DomenicHampson/IR-Camera-Interface-PCB/FrostByte_IRCamera_PCB.kicad_pcb

## KiCad design FrostByte_IRCamera_PCB.kicad_pcb (2026-02-06)

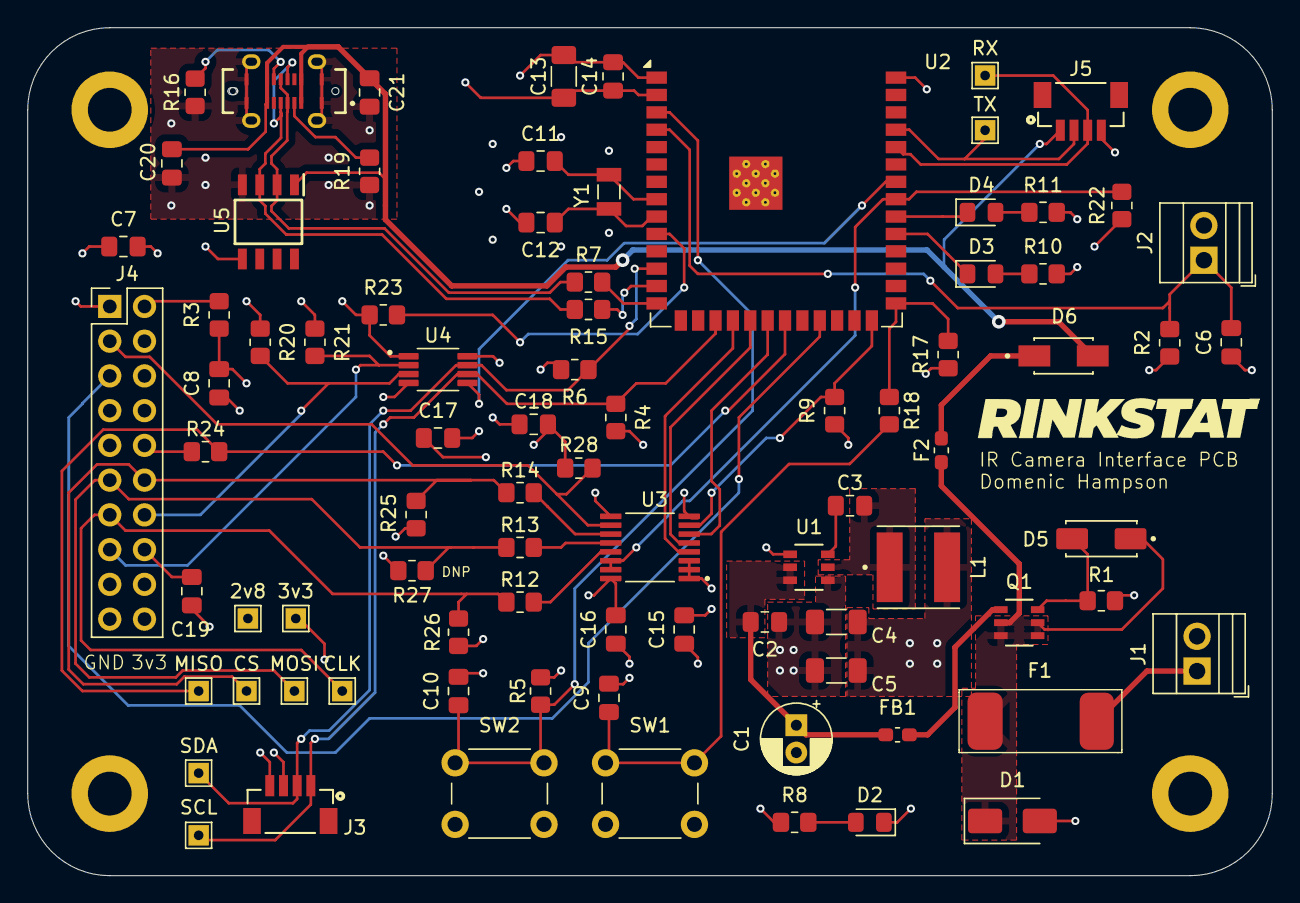
[picture p1: board FrostByte_IRCamera_PCB.kicad_pcb from above]

Board: 4 copper layers, 91.0 x 62.0 mm, 88 parts (0 on the bottom side), 51 nets.

Parts:
2v8, 3v3: TestPoint; TestPoint_THTPad_1.5x1.5mm_Drill0.7mm
C1: 47uF; CP_Radial_D5.0mm_P2.00mm
C2: 2.2uF; C_0805_2012Metric_Pad1.18x1.45mm_HandSolder
C3, C6, C8, C9, C10, C14, C15, C16, C17, C18, C20, C21: 0.1uF; C_0805_2012Metric_Pad1.18x1.45mm_HandSolder
C4, C5: 22uF; C_1206_3216Metric_Pad1.33x1.80mm_HandSolder
C7, C19: 1uF; C_0805_2012Metric_Pad1.18x1.45mm_HandSolder
C11, C12: 8pF; C_0805_2012Metric_Pad1.18x1.45mm_HandSolder
C13: DNP; C_1206_3216Metric_Pad1.33x1.80mm_HandSolder
CLK: TestPoint; TestPoint_THTPad_1.5x1.5mm_Drill0.7mm
CS: TestPoint; TestPoint_THTPad_1.5x1.5mm_Drill0.7mm
D1: SMAJ33A; D_SMA
D2: LED_Red; LED_0805_2012Metric_Pad1.15x1.40mm_HandSolder
D3: LED_Blue; LED_0805_2012Metric_Pad1.15x1.40mm_HandSolder
D4: LED_Green; LED_0805_2012Metric_Pad1.15x1.40mm_HandSolder
D5: 15V; DIOM5226X240N
D6: B240A-13-F; DIOM5226X230N
F1: 3404.2413.11; Small_SMD_Fuse_Holder
F2: 1A Slow Blow; Fuse_0603_1608Metric_Pad1.05x0.95mm_HandSolder
FB1: PE-0603PFB121ST; C_0603_1608Metric_Pad1.08x0.95mm_HandSolder
H1, H2, H3, H4: MountingHole_Pad; MountingHole_3.2mm_M3_DIN965_Pad
J1: Power_Input; TerminalBlock_Xinya_XY308-2.54-2P_1x02_P2.54mm_Horizontal
J2: Conn_01x02_Socket; TerminalBlock_Xinya_XY308-2.54-2P_1x02_P2.54mm_Horizontal
J3: Conn_01x04_Socket; CONN4_BM04B-SRSS_JST
J4: Conn_02x10; PinHeader_2x10_P2.54mm_Vertical
J5: UART; CONN4_BM04B-SRSS_JST
J6: USB4120-03-C_REVA6; GCT_USB4120-03-C_REVA6
L1: 3.9uH; IND_VLS6045EX-6R8M
MISO: TestPoint; TestPoint_THTPad_1.5x1.5mm_Drill0.7mm
MOSI: TestPoint; TestPoint_THTPad_1.5x1.5mm_Drill0.7mm
Q1: SI3127DV-T1-GE3; TSOP-6L_VIS
R1: 100k; R_0805_2012Metric_Pad1.20x1.40mm_HandSolder
R2: 10k 1%; R_0805_2012Metric_Pad1.20x1.40mm_HandSolder
R3, R5, R9, R17, R22, R23, R25, R28: 10k; R_0805_2012Metric_Pad1.20x1.40mm_HandSolder
R4, R6, R20, R21: 2.2k; R_0805_2012Metric_Pad1.20x1.40mm_HandSolder
R7, R12, R13, R15, R24: 22; R_0805_2012Metric_Pad1.20x1.40mm_HandSolder
R8: 270; R_0805_2012Metric_Pad1.20x1.40mm_HandSolder
R10: 47; R_0805_2012Metric_Pad1.20x1.40mm_HandSolder
R11: 150; R_0805_2012Metric_Pad1.20x1.40mm_HandSolder
R14: 33; R_0805_2012Metric_Pad1.20x1.40mm_HandSolder
R16, R19: 5.1k; R_0805_2012Metric_Pad1.20x1.40mm_HandSolder
R18: 0; R_0805_2012Metric_Pad1.20x1.40mm_HandSolder
R26, R27: 47k; R_0805_2012Metric_Pad1.20x1.40mm_HandSolder
RX: TestPoint; TestPoint_THTPad_1.5x1.5mm_Drill0.7mm
SCL: TestPoint; TestPoint_THTPad_1.5x1.5mm_Drill0.7mm
SDA: TestPoint; TestPoint_THTPad_1.5x1.5mm_Drill0.7mm
SW1, SW2: SW_Push; SW_PUSH_6mm
TX: TestPoint; TestPoint_THTPad_1.5x1.5mm_Drill0.7mm
U1: AP63203WU-7; SOT-23-THIN-6_DDC_TEX
U2: ESP32-S3-WROOM-1
U3: SN74AXC4T245PWR; SOP65P640X120-16N
U4: TCA9517DGKR; SOP65P490X110-8N
U5: USB6B1RL; SOIC127P600X175-8N
Y1: 32.768kHz; XTAL_FC-135R_32.7680KA-AG0

Connections:
+2V8: 2v8.1, C8.1, C16.1, C18.2, C19.2, J4.16, R3.2, R20.1, R21.1, R23.2, R25.1, R26.1, R28.2, U3.16 (VCCB), U4.1 (VCCA)
+3.3V: 3v3.1, C4.1, C5.1, C7.1, C13.1, C14.1, C15.1, C17.1, J3.3, J4.20, L1.2, R2.1, R4.1, R5.2, R6.1, R8.1, R9.1, R10.1, R11.1, R17.2, R22.1, U1.1 (FB), U2.2 (3V3), U3.1 (VCCA), U3.2 (1DIR), U3.3 (2DIR), U4.8 (VCCB)
+5V: C20.2, C21.2, D6.A, J5.1, J6.A4 (VBUS_A), J6.A9 (VBUS_A__1), J6.B4 (VBUS_B), J6.B9 (VBUS_B__1), U5.1 (VCC_1)
/MCU/CAM_TEMP: C6.1, J2.1, R2.2, U2.4 (IO4)
/MCU/EN_I2C: U2.34 (IO41), U4.5 (EN)
/MCU/EN_SPI: R22.2, U2.33 (IO40), U3.14 (2~OE), U3.15 (1~OE)
/MCU/LED_1: D3.1 (K), U2.31 (IO38)
/MCU/LED_2: D4.1 (K), U2.32 (IO39)
/MCU/RESET_L: J4.3, R28.1, U3.10 (2B2)
/MCU/RESET_L_3v3: R9.2, U2.26 (IO45), U3.7 (2A2)
/MCU/RX: J5.3, RX.1, U2.36 (RXD0)
/MCU/SCL_A: J3.1, R4.2, SCL.1, U2.17 (IO9), U4.7 (SCLB)
/MCU/SCL_B: J4.14, R20.2, U4.2 (SCLA)
/MCU/SDA_A: J3.2, R6.2, SDA.1, U2.12 (IO8), U4.6 (SDAB)
/MCU/SDA_B: J4.15, R21.2, U4.3 (SDAA)
/MCU/SPI_CLK: CLK.1, J4.13, R12.1, R26.2
/MCU/SPI_CLK_3v3: U2.20 (IO12), U3.6 (2A1)
/MCU/SPI_CS: CS.1, J4.12, R14.1, R25.2
/MCU/SPI_CS_3v3: U2.18 (IO10), U3.4 (1A1)
/MCU/SPI_MISO: MISO.1, R24.2, U2.21 (IO13)
/MCU/SPI_MOSI: J4.11, MOSI.1, R13.1, R27.1
/MCU/SPI_MOSI_3v3: U2.19 (IO11), U3.5 (1A2)
/MCU/TX: J5.2, TX.1, U2.37 (TXD0)
/MCU/VSYNC: J4.5, U2.23 (IO21)
/Peripherals/USB_D+: J6.A6 (D1+), J6.B6 (D2+), R7.1, R7.2, U2.14 (IO20), U5.2 (I/O1_1)
/Peripherals/USB_D-: J6.A7 (D1-), J6.B7 (D2-), R15.1, R15.2, U2.13 (IO19), U5.3 (I/O2_1)
/Power_Circuitry/source: D1.1 (A1), D5.1 (K), F1.2, F2.1, Q1.1, Q1.2, Q1.5, Q1.6
GND: C1.2, C2.2, C4.2, C5.2, C6.2, C7.2, C8.2, C9.1, C10.1, C11.1, C12.1, C13.2, C14.2, C15.2, C16.2, C17.2, C18.1, C19.1, C20.1, C21.1, D1.2 (A2), D2.1 (K), H1.1, H2.1, H3.1, H4.1, J1.2, J2.2, J3.4, J4.1, J4.19, J5.4, J6.A1 (GND_A), J6.A12 (GND_A__1), J6.B1 (GND_B), J6.B12 (GND_B__1), J6.S1 (SHIELD), J6.S2 (SHIELD__1), J6.S3 (SHIELD__2), J6.S4 (SHIELD__3), R1.1, R16.1, R19.2, R27.2, SW1.1, SW2.1, U1.4 (GND), U2.1 (GND), U2.40 (GND), U2.41 (GND), U3.8 (GND-1), U3.9 (GND), U4.4 (GND), U5.4 (GND_1), U5.5 (GND_2)
unnamed: C9.2, R18.2, SW1.2
unnamed: D2.2 (A), R8.2
unnamed: D3.2 (A), R10.2
unnamed: D4.2 (A), R11.2
unnamed: D5.2 (A), Q1.3, R1.2
unnamed: D6.C, F2.2
unnamed: FB1.1, Q1.4
unnamed: F1.1, J1.1
unnamed: J4.2, R3.1
unnamed: J4.10, R24.1
unnamed: J6.A5 (CC1), R19.1
unnamed: J6.B5 (CC2), R16.2
unnamed: C3.1, U1.6 (BST)
unnamed: C1.1, C2.1, FB1.2, U1.2 (EN), U1.3 (VIN)
unnamed: C3.2, L1.1, U1.5 (SW)
unnamed: C10.2, R5.1, SW2.2, U2.3 (EN)
unnamed: R17.1, R18.1, U2.27 (IO0)
unnamed: C11.2, U2.8 (IO15), Y1.2
unnamed: C12.2, U2.9 (IO16), Y1.1
unnamed: R23.1, U2.10 (IO17)
unnamed: R12.2, U3.13 (1B1)
unnamed: R13.2, U3.12 (1B2)
unnamed: R14.2, U3.11 (2B1)
