DomenicHampson/IR-Camera-Interface-PCB/(commit log)

2026-01-02 Completed Circuit Rev 1
    [FrostByte_IRCamera_PCB.kicad_pcb, FrostByte_IRCamera_PCB.kicad_sch, mcu.kicad_sch, peripherals.kicad_sch, power_circuitry.kicad_sch, programming_circuitry.kicad_sch, untitled.kicad_sch]
2026-01-03 Schematic + Layout Review Ready First Rev
    [FrostByte_IRCamera_PCB.kicad_pcb, mcu.kicad_sch, peripherals.kicad_sch]
2026-01-07 rev 2 added usb prog and i2c level shifting
    [FrostByte_IRCamera_PCB.kicad_pcb, FrostByte_IRCamera_PCB.kicad_sch, mcu.kicad_sch, peripherals.kicad_sch, power_circuitry.kicad_sch, programming.kicad_sch]
2026-01-10 minor fixes and updated PCB layout
    [FrostByte_IRCamera_PCB.kicad_pcb, peripherals.kicad_sch, power_circuitry.kicad_sch]
2026-01-21 Updated Schematic and fixed some routing issues
    [FrostByte_IRCamera_PCB.kicad_pcb, mcu.kicad_sch, peripherals.kicad_sch, power_circuitry.kicad_sch]
2026-01-31 Layout + Schem complete, rough routing
    [FrostByte_IRCamera_PCB.kicad_pcb, peripherals.kicad_sch]
2026-02-06 Rev A PCB Ordered
    [FrostByte_IRCamera_PCB-B_Cu.gbl, FrostByte_IRCamera_PCB-B_Mask.gbs, FrostByte_IRCamera_PCB-B_Silkscreen.gbo, FrostByte_IRCamera_PCB-Edge_Cuts.gm1, FrostByte_IRCamera_PCB-F_Cu.gtl, FrostByte_IRCamera_PCB-F_Mask.gts, FrostByte_IRCamera_PCB-F_Paste.gtp, FrostByte_IRCamera_PCB-F_Silkscreen.gto]
